lambdalainen/FM-Radio/DS01-254-L-01BE.stp

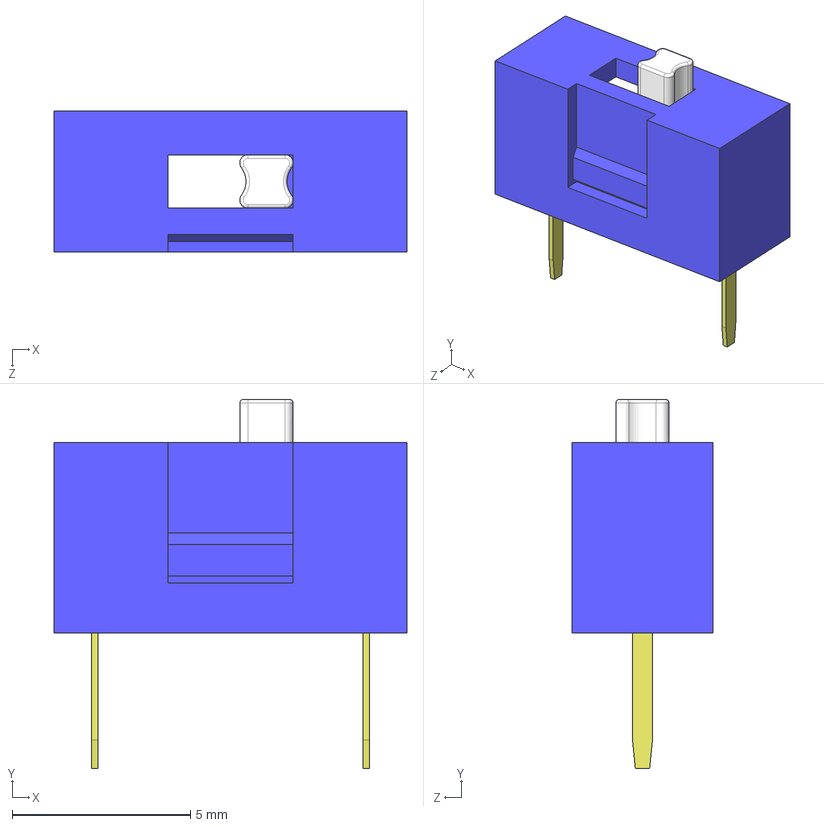
[picture p1: CAD file, 2024-01-26]
DS01-254-L-01BE.stp
9.90 x 10.4 x 3.96 mm
