lambdalainen/FM-Radio/ECS-.327-12.5-34B-TR.stp

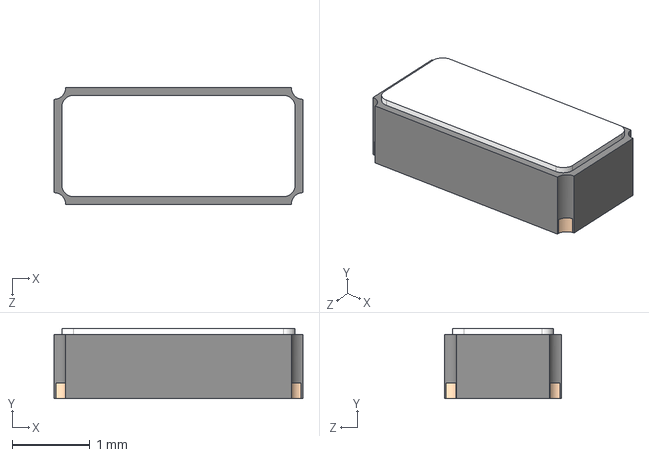
[picture p2: CAD file, 2024-01-26]
ECS-.327-12.5-34B-TR.stp
3.20 x 0.9 x 1.50 mm
