lambdalainen/FM-Radio/91A1A-B28-A25L.stp

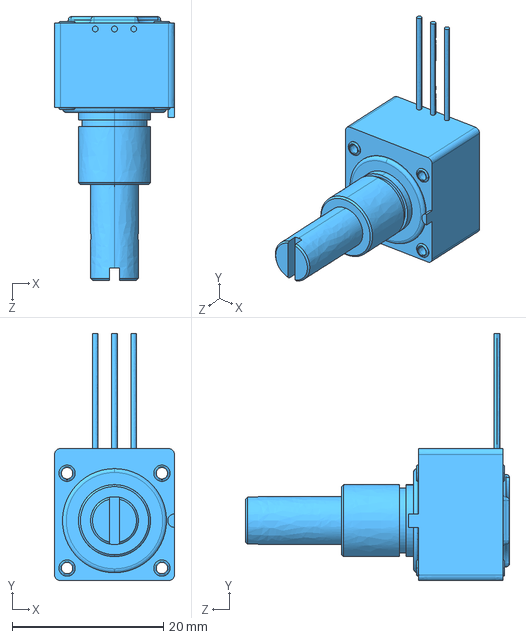
[picture p3: CAD file, 2024-01-25]
91A1A-B28-A25L.stp
15.9 x 32.7 x 34.9 mm
