lambdalainen/FM-Radio/3362P-1-102LF.stp

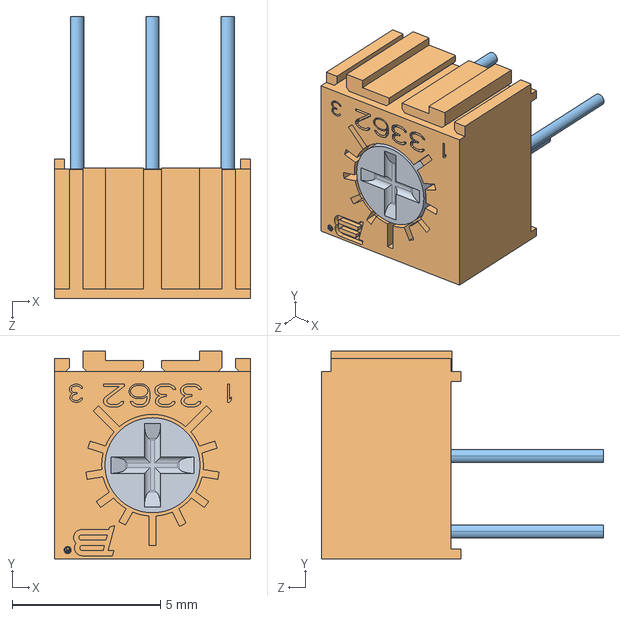
[picture p4: CAD file, 2024-01-25]
3362P-1-102LF.stp
6.60 x 6.99 x 9.50 mm
