lambdalainen/FM-Radio/FM Radio.kicad_pcb

## KiCad design FM Radio.kicad_pcb (2024-02-04)

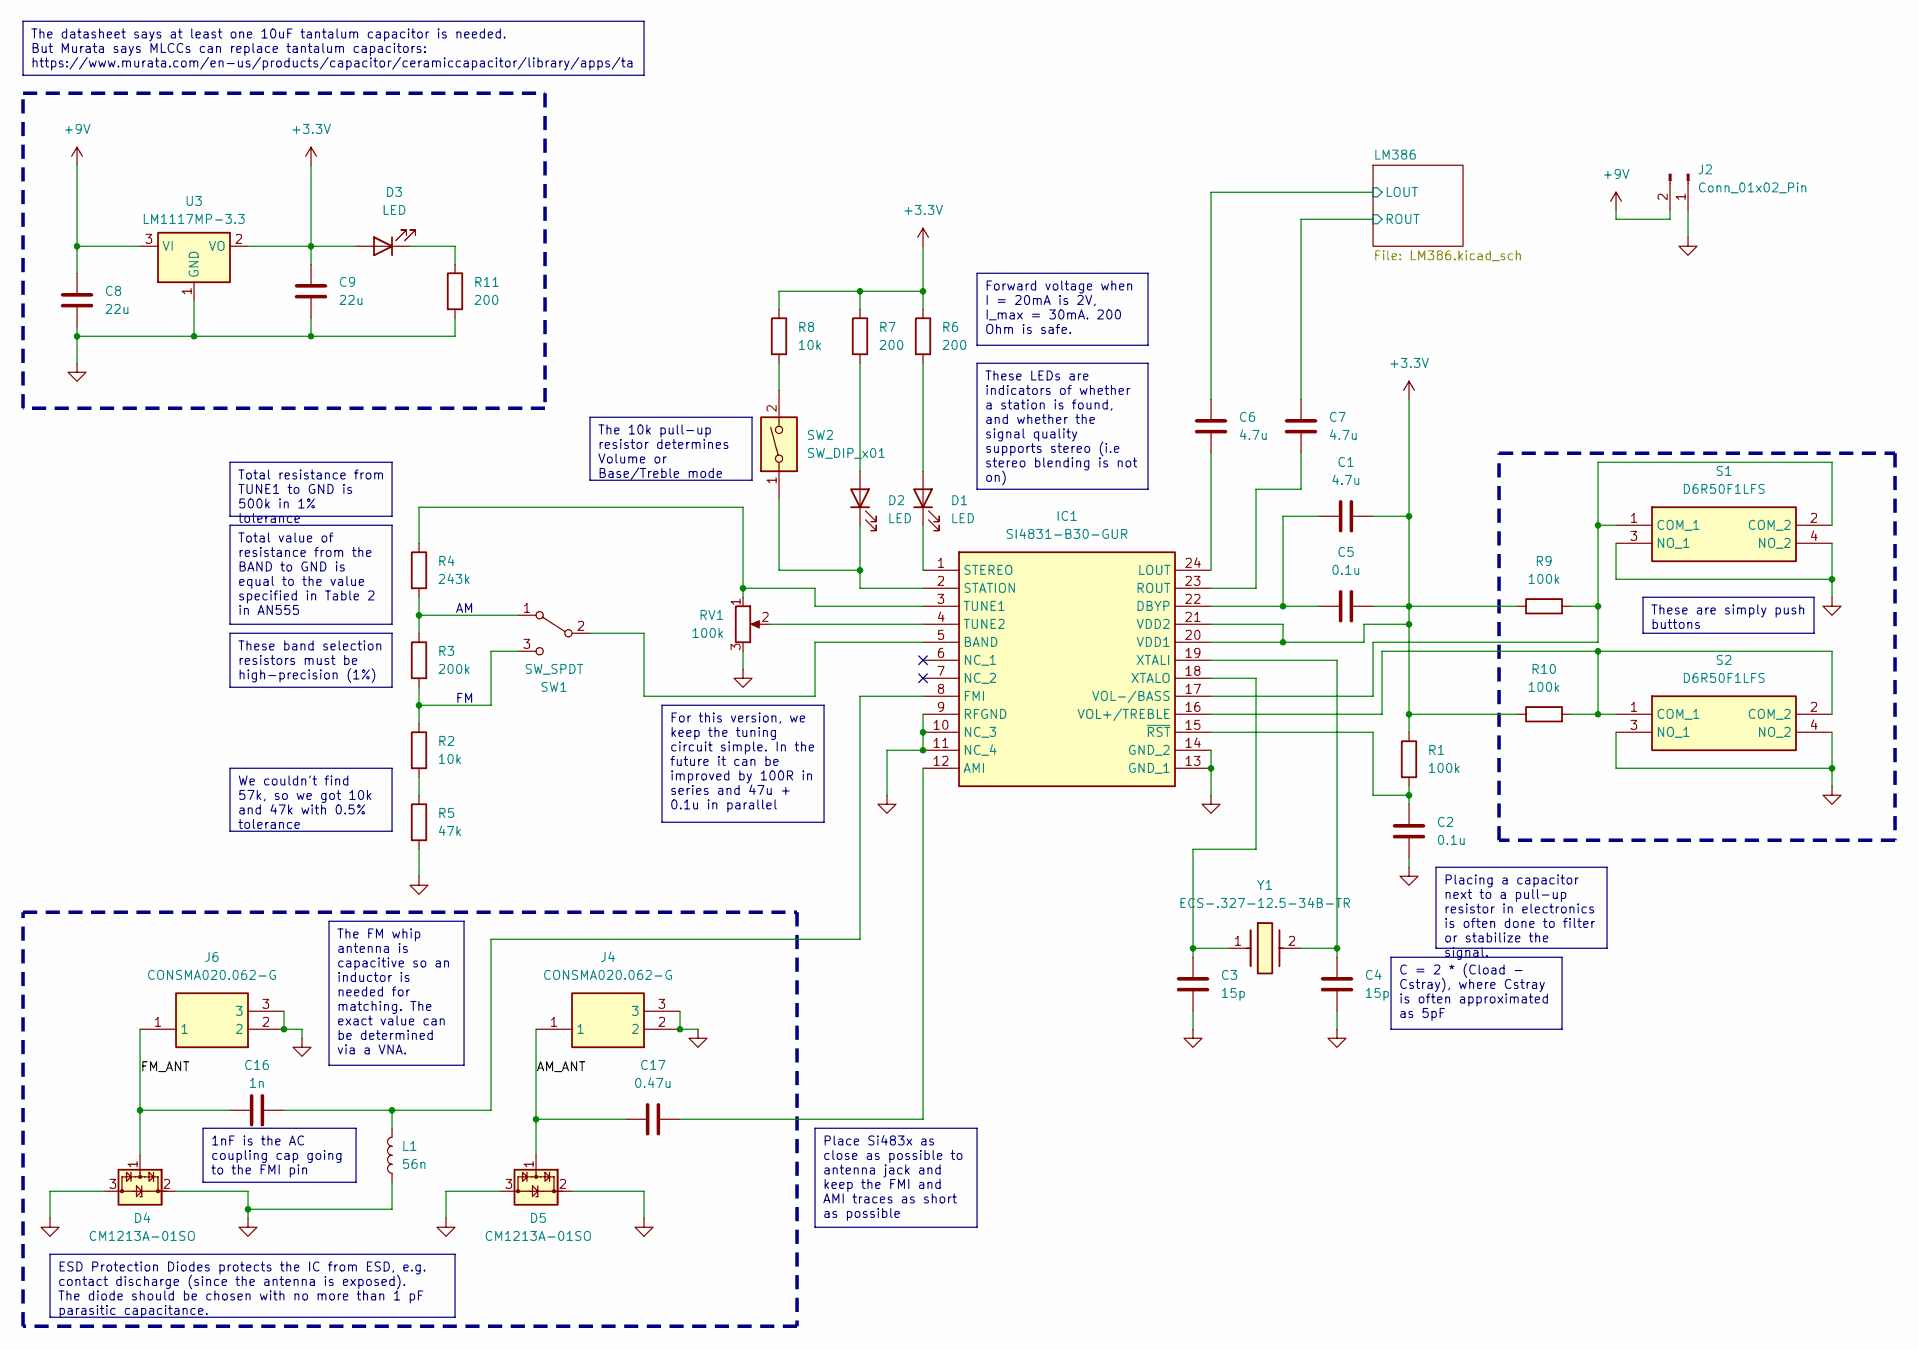
[picture p5: schematic FM Radio.kicad_sch]

Parts:
C1, C6, C7: 4.7u; C_0603_1608Metric
C2, C5: 0.1u; C_0603_1608Metric
C3, C4: 15p; C_0603_1608Metric
C8: 22u; C_0805_2012Metric
C9: 22u; CAPC2012X145N
C16: 1n; C_0603_1608Metric
C17: 0.47u; C_0603_1608Metric
D1, D2, D3: LED; LED_0603_1608Metric
D4, D5: CM1213A-01SO; SOT-23-3
IC1: SI4831-B30-GUR; SOP64P600X175-24N; Manufacturer_Part_Number SI4831-B30-GUR; Mouser Part Number 634-SI4831-B30-GUR
J2: Conn_01x02_Pin; PinHeader_1x02_P2.54mm_Vertical
J4, J6: CONSMA020.062-G; CONSMA020062G; Manufacturer_Part_Number CONSMA020.062-G; Mouser Part Number 712-CONSMA020.062-G
L1: 56n; L_0603_1608Metric
R1, R9, R10: 100k; R_0603_1608Metric
R2: 10k; R_0603_1608Metric
R3: 200k; R_0603_1608Metric
R4: 243k; R_0603_1608Metric
R5: 47k; R_0603_1608Metric
R6: 200; RESC1608X55N
R7, R11: 200; R_0603_1608Metric
R8: 10k; R_0603_1608Metric_Pad0.98x0.95mm_HandSolder
RV1: 100k; 91A1AB28B13L
S1, S2: D6R50F1LFS; D6R40F1LFS; Manufacturer_Part_Number D6R50F1LFS; Mouser Part Number 611-D6R50F1LFS
SW1: SW_SPDT; SW_SPDT_PCM12
SW2: SW_DIP_x01; DS01254L01BE
U3: LM1117MP-3.3; SOT-223-3_TabPin2
Y1: ECS-.327-12.5-34B-TR; ECX-31B; Manufacturer_Part_Number ECS-.327-12.5-34B-TR; Mouser Part Number 520-327-12.5-34B

Connections:
+3.3V: C1.2, C5.2, C9.2, D3.2 (A), IC1.20 (VDD1), IC1.21 (VDD2), R1.1, R6.1, R7.1, R8.1, R9.1, R10.1, U3.2 (VO)
/AM_ANT: C17.2, D5.1 (CH1), J4.1
/FM_ANT: C16.2, D4.1 (CH1), J6.1
/LM386/LOUT: C6.2; also elsewhere on the board
/LM386/ROUT: C7.2; also elsewhere on the board
GND: C2.2, C3.2, C4.2, C8.1, C9.1, D4.2 (VP), D4.3 (VN), D5.2 (VP), D5.3 (VN), IC1.9 (RFGND), IC1.10 (NC_3), IC1.11 (NC_4), IC1.13 (GND_1), IC1.14 (GND_2), J2.1, J4.2, J4.3, J6.2, J6.3, L1.1, R5.2, R11.2, RV1.3, S1.3 (NO_1), S1.4 (NO_2), S2.3 (NO_1), S2.4 (NO_2), U3.1 (GND); also elsewhere on the board
unnamed: D1.2 (A), R6.2
unnamed: D1.1 (K), IC1.1 (STEREO)
unnamed: D2.2 (A), R7.2
unnamed: D2.1 (K), IC1.2 (STATION), SW2.1
unnamed: D3.1 (K), R11.1
unnamed: C17.1, IC1.12 (AMI)
unnamed: IC1.5 (BAND), SW1.2 (B)
unnamed: C1.1, C5.1, IC1.22 (DBYP)
unnamed: C16.1, IC1.8 (FMI), L1.2
unnamed: C6.1, IC1.24 (LOUT)
unnamed: C7.1, IC1.23 (ROUT)
unnamed: IC1.3 (TUNE1), R4.1, RV1.1
unnamed: IC1.4 (TUNE2), RV1.2
unnamed: IC1.16 (VOL+/TREBLE), R10.2, S2.1 (COM_1), S2.2 (COM_2)
unnamed: IC1.17 (VOL-/BASS), R9.2, S1.1 (COM_1), S1.2 (COM_2)
unnamed: C4.1, IC1.19 (XTALI), Y1.2
unnamed: C3.1, IC1.18 (XTALO), Y1.1
unnamed: C2.1, IC1.15 (~RST), R1.2
unnamed: R2.2, R5.1
unnamed: R8.2, SW2.2
unnamed: R3.1, R4.2, SW1.1 (A)
unnamed: R2.1, R3.2, SW1.3 (C)

Notes on the sheet:
Placing a capacitor next to a pull-up resistor in electronics is often done to filter or stabilize the signal.
We couldn't find 57k, so we got 10k and 47k with 0.5% tolerance
These are simply push buttons
The FM whip antenna is capacitive so an inductor is needed for matching. The exact value can be determined via a VNA.
These LEDs are indicators of whether a station is found, and whether the signal quality supports stereo (i.e stereo blending is not on)
The 10k pull-up resistor determines Volume or Base/Treble mode
Place Si483x as close as possible to antenna jack and keep the FMI and AMI traces as short as possible
Total value of resistance from the BAND to GND is equal to the value specified in Table 2 in AN555
The datasheet says at least one 10uF tantalum capacitor is needed. But Murata says MLCCs can replace tantalum capacitors: https://www.murata.com/en-us/products/capacitor/ceramiccapacitor/library/apps/ta
These band selection resistors must be high-precision (1%)
For this version, we keep the tuning circuit simple. In the future it can be improved by 100R in series and 47u + 0.1u in parallel
1nF is the AC coupling cap going to the FMI pin
Forward voltage when I = 20mA is 2V, I_max = 30mA. 200 Ohm is safe.
Total resistance from TUNE1 to GND is 500k in 1% tolerance
ESD Protection Diodes protects the IC from ESD, e.g. contact discharge (since the antenna is exposed). The diode should be chosen with no more than 1 pF parasitic capacitance.
C = 2 * (Cload - Cstray), where Cstray is often approximated as 5pF

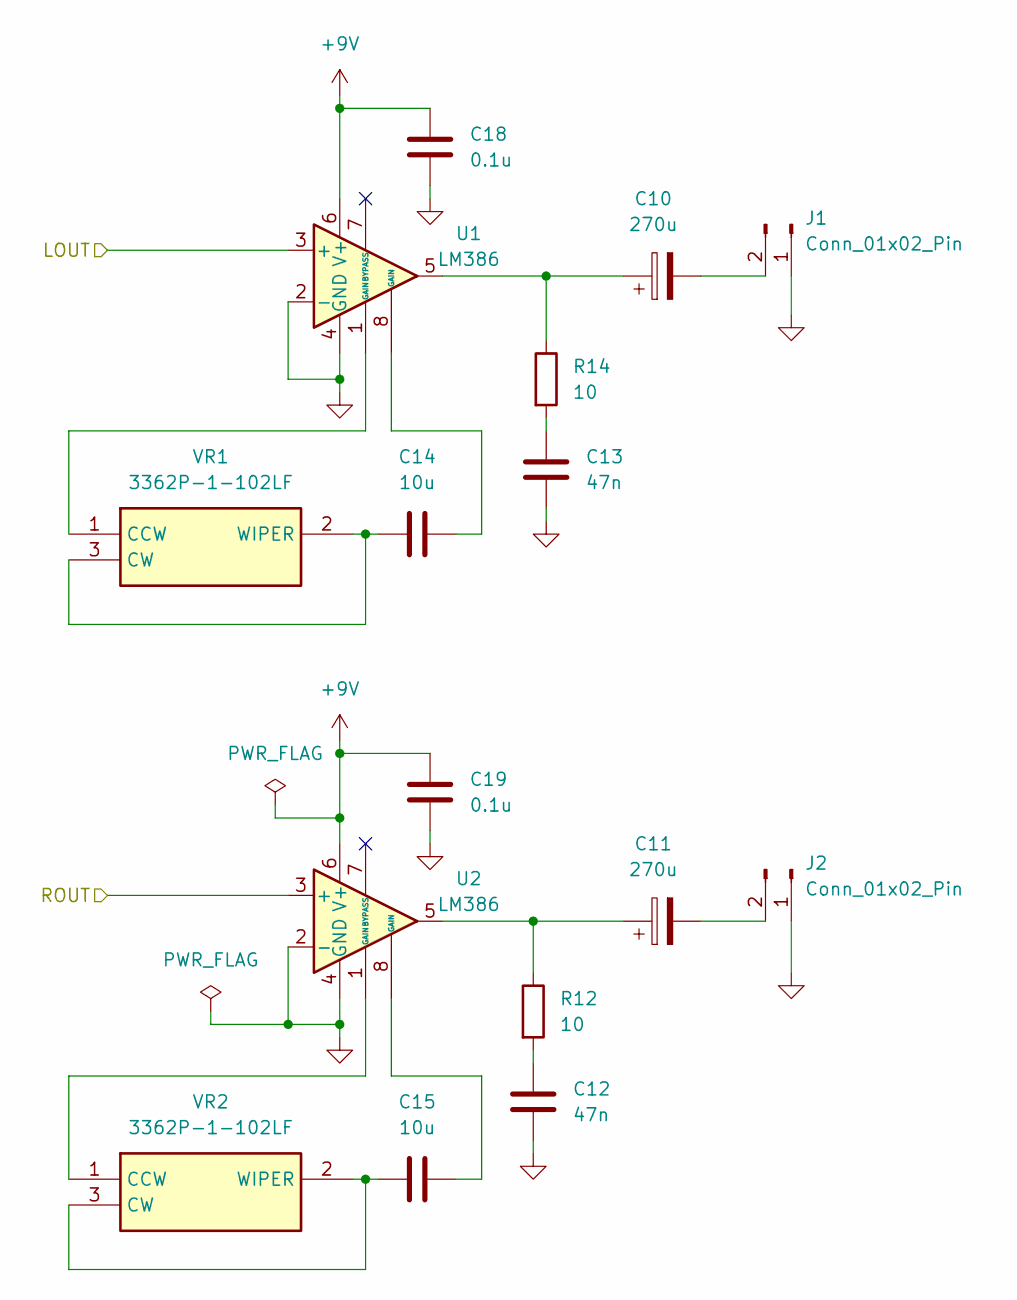
[picture p6: schematic LM386.kicad_sch]

Parts:
C10, C11: 270u; CP_Radial_D6.3mm_P2.50mm
C12, C13: 47n; C_0603_1608Metric
C14, C15: 10u; C_0603_1608Metric
C18, C19: 0.1u; C_0603_1608Metric
J1, J2: Conn_01x02_Pin; PinHeader_1x02_P2.54mm_Vertical
R12, R14: 10; R_0603_1608Metric
U1, U2: LM386; SOIC-8_3.9x4.9mm_P1.27mm
VR1, VR2: 3362P-1-102LF; 3362P_1; Manufacturer_Part_Number 3362P-1-102LF; Mouser Part Number 652-3362P-1-102LF

Connections:
/LM386/LOUT: U1.3 (+); also elsewhere on the board
/LM386/ROUT: U2.3 (+); also elsewhere on the board
GND: C12.2, C13.2, C18.1, C19.1, J1.1, J2.1, U1.2 (-), U1.4 (GND), U2.2 (-), U2.4 (GND); also elsewhere on the board
unnamed: C10.1, R14.1, U1.5
unnamed: C11.1, R12.1, U2.5
unnamed: C12.1, R12.2
unnamed: C13.1, R14.2
unnamed: C14.2, U1.8 (GAIN)
unnamed: C15.2, U2.8 (GAIN)
unnamed: C10.2, J1.2
unnamed: U1.1 (GAIN), VR1.1 (CCW)
unnamed: C14.1, VR1.2 (WIPER), VR1.3 (CW)
unnamed: U2.1 (GAIN), VR2.1 (CCW)
unnamed: C15.1, VR2.2 (WIPER), VR2.3 (CW)

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
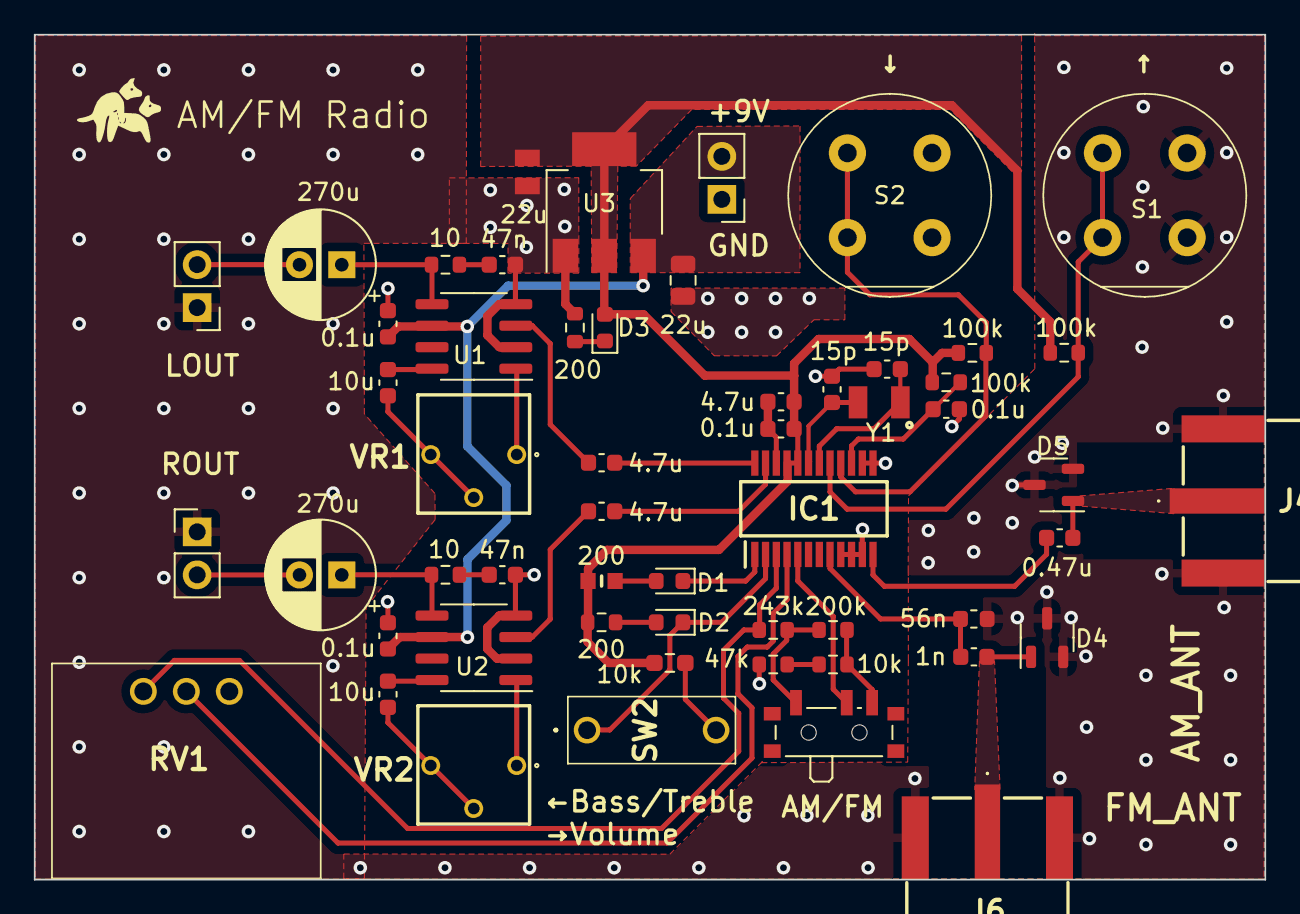
[picture p7: board FM Radio.kicad_pcb from above]

Board: 2 copper layers, 72.7 x 49.9 mm, 55 parts (0 on the bottom side), 41 nets.

Other parts of the board:
J3: Conn_01x02_Pin; PinHeader_1x02_P2.54mm_Vertical

Their connections:
GND: J3.1; also elsewhere on the board
