lambdalainen/FM-Radio/(commit log)

2024-01-25 Add 1k trimmer 3362P-1-102LF
    [3362P-1-102LF.stp]
2024-01-25 Add Micro USB Type B Connector 629105150521
    [629105150521.stp]
2024-01-25 Add potentiometer
    We are using 91A1A-B28-A20L but could only find 91A1A-B28-A25L for footprint.
    They should be the same.
    [91A1A-B28-A25L.stp]
2024-01-25 Add SMA connector CONSMA020.062-G
2024-01-26 Add push button D6R50F1LFS (50 green, 40 red)
2024-01-26 Add 32.768 kHz crystal
    [ECS-.327-12.5-34B-TR.stp]
2024-01-26 Add RESC1608X55N footprint (0603)
2024-01-26 Add CAPC2012X145N footprint (0805, 22 uF)
2024-01-26 Add DIP switch DS01-254-L-01BE
    [DS01-254-L-01BE.stp]
2024-01-26 Schematics done and footprint assigned
    [FM Radio.kicad_pcb, FM Radio.kicad_sch, LM386.kicad_sch]
2024-01-27 Remove Micro USB Type B Connector 629105150521 as it is unused
    [629105150521.stp]
2024-01-27 Add comments and fix errors
    [FM Radio.kicad_pcb, FM Radio.kicad_sch, LM386.kicad_sch]
2024-01-27 Fix: VDD not connected
    [FM Radio.kicad_pcb, FM Radio.kicad_sch]
2024-01-29 Generate KiCad design rules from JLCPCB rules
2024-01-29 Change footprint library path
2024-01-29 Fix grounding mistake with the trimmers
    [LM386.kicad_sch]
2024-01-29 Add bypass caps to LM386
    [LM386.kicad_sch]
2024-01-29 Very rough component placement
    [FM Radio.kicad_pcb]
2024-02-04 Complete layout
    [FM Radio.kicad_pcb, FM Radio.kicad_sch, LM386.kicad_sch]
2024-02-04 Plot Gerber
    [FM Radio.kicad_pcb]
